piit79/Sub-Etha-Pad/README.md

# Sub-Etha Pad

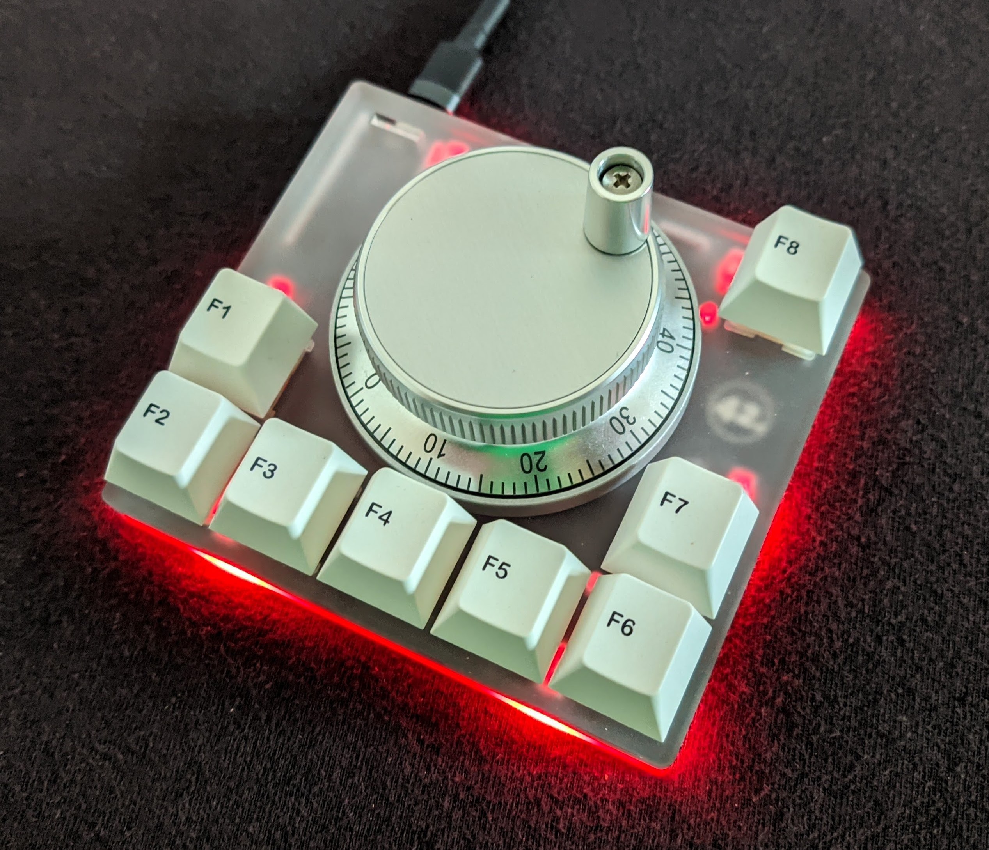
[picture p1: sub-etha-pad-m/Sub-Etha-Pad-M.jpg]
Sub-Etha Pad 0.95


Mechanical macropad with a large "CNC" rotary encoder. Uses Pro Micro controller (or 
compatible, like Elite-C, nice!nano etc.)

Inspired by [EncoderPad RP2040](https://github.com/jpconstantineau/EncoderPad_RP2040),
but created from scratch in KiCad 6.

Instead of an FR4 (PCB) sandwich case, it uses a layered acrylic case made from 5 mm sheets.

Kits will be available at [42keebs.eu](https://42keebs.eu/) some time in August 2022.

**Work in progress - currently untested!**

## Versions

All versions feature RGB underglow via SK6812-MINI-E LED modules.

### Sub-Etha Pad S

_(Planned)_

* Rotary encoder
* 3 keys

### [Sub-Etha Pad M](https://github.com/piit79/Sub-Etha-Pad/tree/main/sub-etha-pad-m)

* Rotary encoder
* 8 keys
* Vertical 0.91" 128x32 pixel OLED display

### Sub-Etha Pad L

_(Planned)_

* Rotary encoder
* 14 keys
* High-profile acrylic case
