piit79/Sub-Etha-Pad/(commit log)

2022-07-11 Initial version 0.95 of CNCPad M
    [cncpad-m.kicad_pcb, cncpad-m.kicad_sch]
2022-07-11 Add missing I2C pullups; change encoder header
    [cncpad-m.kicad_pcb, cncpad-m.kicad_sch]
2022-07-11 Add 42. Keebs KiCad library as a submodule
2022-07-11 Rename to Sub-Etha Pad; lots of little updates
    * Add missing I2C pullups
    * Move RGB LEDs inward
    * Add additional top-facing RGB LED
    [cncpad-m.kicad_pcb, sub-etha-pad-m.kicad_pcb, sub-etha-pad-m.kicad_sch]
2022-07-11 Update 42. Keebs KiCad library
2022-07-11 Use logos from the 42. Keebs library; remove local copies
    [sub-etha-pad-m.kicad_pcb, sub-etha-pad-m.kicad_sch]
2022-07-11 Switch to 5.1k I2C pullup resistors
    [sub-etha-pad-m.kicad_pcb, sub-etha-pad-m.kicad_sch]
2022-07-11 Add new schematic backups to .gitignore
2022-07-11 Small improvements & cleanups
    [sub-etha-pad-m.kicad_pcb]
2022-07-11 Add TRRS socket for I2C keyboard chaining
    [sub-etha-pad-m.kicad_pcb, sub-etha-pad-m.kicad_sch]
2022-07-11 Update the 42. Keebs KiCad library
2022-07-11 Switch to 42. Keebs Kailh MX socket footprints
    [sub-etha-pad-m.kicad_pcb, sub-etha-pad-m.kicad_sch]
2022-07-11 Add optional switch LED for SW8
    [sub-etha-pad-m.kicad_pcb, sub-etha-pad-m.kicad_sch]
2022-07-11 Switch all remaining footprints to libraries; remove local footprint library
    [sub-etha-pad-m.kicad_pcb, sub-etha-pad-m.kicad_sch]
2022-07-11 Slightly improve the schematic
    [sub-etha-pad-m.kicad_sch]
2022-07-11 Switch to 42. Keebs SK6812 MINI-E footprint
    [sub-etha-pad-m.kicad_pcb, sub-etha-pad-m.kicad_sch]
2022-07-11 Sub-Etha Pad M version 1.0
    Update READMEs, add photo
    [sub-etha-pad-m.kicad_pcb]
2022-08-29 Remove unused local footprint library sub-etha
2022-08-29 Sub-Etha Pad M version 1.1
    * Flip OLED footprint so that it doesn't collide with the Pro Micro USB-C socket
    * Add pads to CNC encoder mounting holes to protect the PCB
    * Move upwards-facing RGB LEDs to the end of the chain and make them independent
    [sub-etha-pad-m.kicad_pcb, sub-etha-pad-m.kicad_sch]
